narmod/arroka-pro90-wifi/(commit log)

2026-04-17 Update CN8 connector position in README
2026-05-01 Update README with ESP32 compatibility details
2026-05-26 b118a2a Fix: remove set_supports_current_temperature for ESPHome 2026.5.x
    [arroka_climate.h]
2026-05-26 Fix: remove set_supports_current_temperature for ESPHome 2026.5.x
    [arroka_climate.h]
